L-McQueen/Syntax-error/schemes/README.md

# ⚡ Arquitectura Eléctrica y Esquemas de Conexión

<div align="center">
  <p><strong>Topología de alimentación desacoplada, gestión de buses digitales, adaptación de niveles lógicos y topología de tierras en 3nIgMa S3t3ki.</strong></p>
  <p>
    
    
    
    
  </p>
</div>

---

> [!IMPORTANT]
> Para consultar la asignación detallada de los 26 pines del conector GPIO de la Orange Pi Zero 2W, revisa directamente el documento complementario: **[PINOUT.md](PINOUT.md)**.

> [!CAUTION]
> Asegúrate de que las tierras lógicas de la Orange Pi, del ESP32-C3-Zero y de ambos convertidores LM2596 confluyan en un **nodo de tierra común en estrella**. Una tierra flotante causará pérdida de sincronismo en la trama serial UART y lecturas erróneas en el bus I2C.

---

## 🔌 1. Diagrama Jerárquico de Alimentación y Conexiones

```
                     ┌────────────────────────────────────────┐
                     │          BATERÍA LiPo 3S (11.1V)       │
                     └───────────────────┬────────────────────┘
                                         │
                         ┌───────────────┴───────────────┐
                         ▼                               ▼
               [LÍNEA DE POTENCIA]               [LÍNEA LÓGICA]
               Buck LM2596 #1 (7.8V)            Buck LM2596 #2 (5.0V)
                         │                               │
                         │               ┌───────────────┴───────────────┐
                         │               ▼                               ▼
                         │        ESP32-C3-Zero  ◄───UART (TX->RX)─── Orange Pi Zero 2W
                         │       (Control Tracción)   (115200 Baud)   (Linux ARM64 / Visión)
                         │               │                               │
                         ▼               ▼                               │
                   Driver DRV8833 ◄──────┘ (GPIO 0-3 PWM, 4 Sleep)       │
                   (Puente H MOSFET)                                     │
                         │                                               │
                         ▼                                               ▼
                  Motores N20 (100:1)                           Periféricos y Buses:
                   (Tracción 7.8V)                               - Bus I2C (/dev/i2c-2):
                                                                   * IMU MPU-6050 (0x68)
                                                                   * OLED SSD1306 (0x3C)
                                                                   * ToF Frontal VL53L1X (0x29)
                                                                   * ToF Lat. Izq VL53L0X (0x30)*
                                                                   * ToF Lat. Der VL53L0X (0x31)*
                                                                 - Bus SPI (/dev/spidev1.0):
                                                                   * PixyCam v2 (Color de suelo)
                                                                 - Puerto USB (/dev/video1):
                                                                   * Webcam USB (Marcadores ArUco)
```

---

## 🔒 2. Aislamiento Galvánico y Desacoplamiento de Ruido

Los micromotores N20 bajo carga brusca o cambios de marcha producen dos perturbaciones graves si comparten alimentación con la lógica:
1. **Caídas de Tensión (*Voltage Sags*):** Al acelerar, la demanda de corriente transitoria puede provocar caídas por debajo de los 4.65V necesarios para la Orange Pi, provocando reinicios (*brownouts*).
2. **Picos Inductivos de Retorno:** La energía inductiva almacenada en el bobinado de los motores genera picos de alta frecuencia.

### Solución Implementada:
* **Doble Regulador Buck LM2596:** Dos módulos independientes alimentados desde la misma batería LiPo 3S. El convertidor #1 abastece exclusivamente los 7.8V de potencia para el DRV8833, mientras el convertidor #2 genera 5.0V limpios con filtrado capacitivo para la SBC y el ESP32-C3-Zero (vía su pin 5V).
* **Tierra en Estrella (*Star Grounding*):** El retorno de corriente de potencia de los motores regresa directamente al borne negativo del módulo LM2596 #1 sin atravesar las pistas lógicas de la Orange Pi.

---

## ⚡ 3. Compatibilidad de Niveles Lógicos UART (3.3V Nativo)

La comunicación entre la Orange Pi Zero 2W y el ESP32-C3-Zero es **estrictamente unidireccional (Simplex)**: la Orange Pi envía paquetes de consigna de velocidad y el ESP32-C3 únicamente ejecuta sin emitir respuesta.

### Justificación de Conexión Directa a 3.3V Nativo:
Tanto el SoC Allwinner H618 de la Orange Pi Zero 2W como el microcontrolador RISC-V del ESP32-C3-Zero operan con **lógica nativa de 3.3V**:
* **Orange Pi Zero 2W:** Pin 11 (`PH2` / `UART5_TX`) emite pulsos seriales a 3.3V (115200 baudios).
* **ESP32-C3-Zero:** Pin `GPIO 20` (`RX`) recibe directamente la señal sin necesidad de divisores resistivos ni convertidores de nivel lógico (logic level shifters).
* El pin `RX` de la Orange Pi (`PH3`) permanece **desconectado**, manteniendo la topología Simplex limpia, segura y minimizando el cableado en el chasis.

---

## 🎛️ 4. Secuencia de Arranque del Bus I2C y Pines XSHUT

Los sensores de distancia VL53L0X comparten de fábrica la misma dirección I2C (`0x29`). Para operar dos sensores laterales simultáneamente en el mismo bus `/dev/i2c-2`, el sistema utiliza una secuencia de arranque secuencial controlada por software mediante los pines **XSHUT**:

```mermaid
sequenceDiagram
    participant OS as Orange Pi (Linux HAL)
    participant XSHUT as Pines GPIO XSHUT
    participant ToFL as VL53L0X Izquierdo
    participant ToFR as VL53L0X Derecho

    OS->>XSHUT: Poner XSHUT_IZQ y XSHUT_DER en LOW (Apagar ambos sensores)
    Note over ToFL,ToFR: Ambos sensores entran en Reset
    OS->>XSHUT: Poner XSHUT_IZQ en HIGH
    Note over ToFL: Enciende en dirección nativa 0x29
    OS->>ToFL: Comando I2C: Reasignar dirección a 0x30
    Note over ToFL: Ahora responde en 0x30
    OS->>XSHUT: Poner XSHUT_DER en HIGH
    Note over ToFR: Enciende en dirección nativa 0x29
    OS->>ToFR: Comando I2C: Reasignar dirección a 0x31
    Note over ToFR: Ahora responde en 0x31
    Note over OS: Bus I2C listo para lecturas continuas
```

### Pines GPIO Asignados para XSHUT:
* **XSHUT Frontal (VL53L1X):** Pin 18 (`PH4`)
* **XSHUT Lateral Izquierdo:** Pin 29 (`PI0`)
* **XSHUT Lateral Derecho:** Pin 31 (`PI15`)

---

## 🔴 5. Pulsadores de Interfaz y Parada de Emergencia

Los pulsadores físicos montados en el chasis se conectan directamente a pines GPIO con resistencia interna de pull-up activada por software:
* **Pulsador Navegar:** Pin 35 (`PI2`) -> Pulsación conecta a GND.
* **Pulsador Seleccionar:** Pin 37 (`PI16`) -> Pulsación conecta a GND.

Durante la carrera autónoma, la rutina de interrupción por cambio de estado (*edge detection*) detecta cualquier pulsación en menos de 20 ms, transmitiendo inmediatamente el paquete `M,0,0,0\n` al ESP32-C3-Zero para detener el robot en seco y regresar al menú OLED.
