L-McQueen/Syntax-error/media/README.md

# 📸 Galería Multimedia y Registros Audiovisuales (`media/`)

<div align="center">
  <p><strong>Registro fotográfico de alta resolución, vistas de ensamble y demostraciones en pista de 3nIgMa S3t3ki.</strong></p>
  <p>
    
    
    
  </p>
</div>

---

> [!TIP]
> Puedes colocar las imágenes en la subcarpeta [robot-photos/](robot-photos/) y los clips o GIFs en [videos/](videos/). Al subirlas a GitHub se visualizarán automáticamente en los marcos inferiores.

---

## 📷 1. Galería Fotográfica del Robot Físico

<div align="center">
  <table>
    <tr>
      <td align="center" width="50%">
        <strong>Vista Isométrica General</strong><br>
        Vista Isométrica<br>
        <i>Chasis completo con torres de sensores y cubierta protectora.</i>
      </td>
      <td align="center" width="50%">
        <strong>Bahía de Electrónica y Cableado</strong><br>
        Bahía de Electrónica<br>
        <i>Distribución aislada de la Orange Pi Zero 2W y el ESP32-C3-Zero.</i>
      </td>
    </tr>
    <tr>
      <td align="center" width="50%">
        <strong>Disposición Frontal de Sensores Láser ToF</strong><br>
        Sensores ToF<br>
        <i>VL53L1X centrado y sensores laterales VL53L0X a 90°.</i>
      </td>
      <td align="center" width="50%">
        <strong>Telemetría en Pantalla OLED SSD1306</strong><br>
        Pantalla OLED<br>
        <i>Menú interactivo y lecturas inerciales en vivo sin computadora.</i>
      </td>
    </tr>
  </table>
</div>

---

## 🎥 2. Demostraciones de Navegación y Pruebas en Pista

| Prueba | Descripción | Enlace / Registro |
| :--- | :--- | :---: |
| **Prueba 1: Pista A (Laberinto 5x5)** | Recorrido 100% autónomo con centrado lateral PID y retorno a casilla de meta sin colisiones. |  |
| **Prueba 2: Pista B (Detección de Rampas)** | Fusión inercial del filtro complementario adaptando la tracción al detectar subida y bajada. |  |
| **Prueba 3: Diagnóstico en Pits** | Verificación de los buses I2C y UART utilizando los pulsadores físicos y la pantalla OLED. |  |
