L-McQueen/Syntax-error/robot-logic/README.md

# 🧠 Lógica de Control, Matemáticas y Algoritmos

<div align="center">
  <p><strong>Fusión sensorial inercial, control lateral PID, máquinas de estados (FSM) y cinemática para 3nIgMa S3t3ki.</strong></p>
  <p>
    
    
    
    
  </p>
</div>

---

> [!NOTE]
> Cada modelo cinemático y ecuación diferencial de control fue verificado primero en el gemelo digital en Webots bajo condiciones de ruido estocástico antes de compilarse en la Capa de Abstracción de Hardware (HAL) de la Orange Pi.

---

## 🧭 1. Fusión Sensorial y Filtro Complementario (Eje Y)

El sensor inercial **MPU-6050** está orientado físicamente con su **eje Y coincidente con la dirección de avance longitudinal** del chasis.

```
                     ORIENTACIÓN DEL SENSOR MPU-6050 EN EL CHASIS
                                        [FRENTE]
                                           ▲
                                           │  +Y (Avance / Cabeceo Pitch)
                                           │
                           -X ◄────────────┼────────────► +X (Aceleración Lateral)
                                           │
                                           ⊙ +Z (Vertical Up / Guiñada Yaw)
                                        [TRASERA]
```

### A. Guiñada Horizontal (Yaw en Eje Z)
Para el seguimiento de rumbo en giros de 90° exactos dentro del laberinto:

1. **Calibración de Sesgo (*Bias*):**  
   Al encender el robot, durante los primeros 2.0 segundos de reposo se promedian 100 muestras de velocidad angular en $Z$ para obtener el error estático $b_z$.

2. **Filtro de Zona Muerta (*Deadband*):**  
   Para evitar que el ruido térmico acumule deriva durante tramos rectos, la velocidad angular se filtra según:

$$
\omega_{z,\text{filtrado}} = 
\begin{cases} 
0 & \text{si } |\omega_z - b_z| < 0.25^\circ/\text{s} \\ 
\omega_z - b_z & \text{en otro caso} 
\end{cases}
$$

3. **Integración Trapezoidal:**  
   A una frecuencia estricta de $f = 50\text{ Hz}$ ($\Delta t = 0.02\text{ s}$), el ángulo de rumbo acumulado se calcula mediante:

$$
\theta_{\text{yaw}}(k) = \theta_{\text{yaw}}(k-1) + \omega_{z,\text{filtrado}} \cdot \Delta t
$$

---

### B. Cabeceo Longitudinal (Pitch en Eje Y) y Detección de Rampas
Para detectar rampas ascendentes y contar correctamente las casillas:

1. **Estimación por Acelerómetro:**  
   El ángulo de inclinación a partir de las componentes de la aceleracion se obtiene con:

$$
\theta_{\text{acc}} = \text{atan2}\left(A_y, \sqrt{A_x^2 + A_z^2}\right) \cdot \left(\frac{180}{\pi}\right)
$$

2. **Filtro Complementario:**  
   Combina la respuesta instantánea del giróscopo en $X$ con la estabilidad a largo plazo del acelerómetro:

$$
\theta_{\text{pitch}}(k) = 0.96 \cdot (\theta_{\text{pitch}}(k-1) + \omega_x \cdot \Delta t) + 0.04 \cdot \theta_{\text{acc}}
$$

3. **Clasificador Dinámico de Terreno:**
   * $\theta_{\text{pitch}} > +6.0^\circ \implies$ **SUBIDA** (robot ascendiendo rampa).
   * $\theta_{\text{pitch}} < -6.0^\circ \implies$ **BAJADA** (robot descendiendo rampa).
   * $-6.0^\circ \le \theta_{\text{pitch}} \le +6.0^\circ \implies$ **PLANO** (superficie horizontal).

---

## 🎯 2. Control Lateral de Centrado PID en Pasillos de 30 cm

En la Pista A (Laberinto), el robot debe navegar a través de celdas de $30\text{ cm} \times 30\text{ cm}$ sin rozar las paredes laterales ni oscilar en pasillos abiertos.

```
                  [Pared Izquierda]                       [Pared Derecha]
             │ ◄─────── 10-15 cm ──────► [Robot] ◄────── 10-15 cm ──────► │
             │   Zona de Peligro: < 10cm          Zona de Peligro: < 10cm │
             │   (Empuje hacia la der)            (Empuje hacia la izq)   │
             │   Zona Neutra: 10 - 15 cm          Zona Neutra: 10 - 15 cm │
             │   (Avance Recto Estable)           (Avance Recto Estable)  │
```

---

### A. Ecuación Geométrica del Error Lateral por Zonas

Para asegurar estabilidad absoluta tanto si existen dos paredes como si el robot pasa junto a una sola pared en una bifurcación:

#### Caso 1: Con 2 Paredes Laterales ($d_L < 22\text{ cm}$ y $d_R < 22\text{ cm}$)
Centrado equidistante simétrico respecto al centro del pasillo:

$$
e(t) = \frac{d_L(t) - d_R(t)}{2}
$$

#### Caso 2: Con 1 Sola Pared (Referencia Pared Izquierda)
Aplica una zona muerta de tolerancia entre 10 cm y 15 cm:

$$
e(t) = 
\begin{cases}
d_L - 0.10 & \text{si } d_L < 0.10\text{ m} \quad (\text{empuje a la derecha para no rozar}) \\
d_L - 0.15 & \text{si } d_L > 0.15\text{ m} \quad (\text{atracción suave hacia la pared}) \\
0.0 & \text{si } 0.10\text{ m} \le d_L \le 0.15\text{ m} \quad (\text{zona neutra: avance recto})
\end{cases}
$$

#### Caso 3: Con 1 Sola Pared (Referencia Pared Derecha)

$$
e(t) = 
\begin{cases}
0.10 - d_R & \text{si } d_R < 0.10\text{ m} \quad (\text{empuje a la izquierda para no rozar}) \\
0.15 - d_R & \text{si } d_R > 0.15\text{ m} \quad (\text{atracción suave hacia la pared}) \\
0.0 & \text{si } 0.10\text{ m} \le d_R \le 0.15\text{ m} \quad (\text{zona neutra: avance recto})
\end{cases}
$$

#### Caso 4: En Espacio Abierto o Intersección ($d \ge 22\text{ cm}$)
El PID se desconecta de inmediato ($e = 0.0$) para evitar correcciones falsas al pasar junto a puertas o cruces.

---

### B. Salida de Control y Modulación de Motores

El error calculado alimenta la ley de control proporcional-derivativa:

$$
u(t) = K_p \cdot e(t) + K_d \cdot \frac{e(t) - e(t - \Delta t)}{\Delta t}
$$

* **Comando Diferencial de Velocidad:**

$$
\begin{aligned}
PWM_{\text{izq}} &= PWM_{\text{base}} - u(t) \\
PWM_{\text{der}} &= PWM_{\text{base}} + u(t)
\end{aligned}
$$

* **Parámetros Sintonizados:**
  - $PWM_{\text{base}} = 160$ (equivalente a $4.2\text{ rad/s}$ en ruedas a 7.8V).
  - $K_p = 1.45$: Corrección proporcional rápida ante desvíos.
  - $K_d = 0.35$: Amortiguamiento para evitar oscilaciones pendulares entre paredes.

---

### C. Estimador Físico de Ángulo con Muros ($\theta_{\text{walls}}$) y Autocalibración del IMU

El giróscopo MPU-6050 económico presenta una deriva térmica continua ($\pm 0.15^\circ/\text{s}$). Tras 60 segundos de carrera, acumula entre $15^\circ$ y $25^\circ$ de desvío; al girar a $90^\circ$, el robot en realidad gira $70^\circ$, entrando cruzado a los pasillos y colisionando.

#### Principio Físico:
En un laberinto ortogonal, **las paredes del pasillo siempre apuntan a los rumbos cardinales físicos exactos ($0^\circ, 90^\circ, 180^\circ, 270^\circ$)**.

```
                EJE LONGITUDINAL DEL PASILLO (PAREDES)
        ─────────────────────────────────────────────────────────────►
                       \
                        \  θ_walls (Ángulo físico relativo al muro)
                         \
                          ► [ROBOT] (Avanza a velocidad lineal v)
```

#### Procedimiento de Estimación y Compensación Continua:

1. **Evolución Temporal de la Métrica Lateral $m$:**  
   Al avanzar en el pasillo a velocidad constante $v = 0.084\text{ m/s}$, el robot registra la evolución temporal de la métrica lateral $m$:

$$
m(t) = 
\begin{cases}
\dfrac{d_L(t) - d_R(t)}{2} & \text{si hay 2 paredes} \\
d_L(t) & \text{si hay pared izquierda} \\
-d_R(t) & \text{si hay pared derecha}
\end{cases}
$$

2. **Estimación del Ángulo Físico Real con los Muros ($\theta_{\text{walls}}$):**  
   Sobre una ventana temporal $\Delta t$ con desplazamiento $\Delta s = v \cdot \Delta t$:

$$
\theta_{\text{walls}} = -\frac{1}{v} \frac{dm}{dt} = -\frac{m(t) - m(t - \Delta t)}{\Delta s}
$$

donde $\theta_{\text{walls}}$ representa el ángulo físico real del chasis respecto a las paredes, acotado por seguridad a $\pm 15^\circ$.

3. **Cálculo de la Deriva Instantánea del IMU ($\epsilon_{\text{deriva}}$):**  
   La diferencia entre el rumbo que reporta el giróscopo ($\psi_{\text{imu}}$) y la orientación física del muro ($\psi_{\text{meta}} + \theta_{\text{walls}}$) es la **deriva neta del IMU**:

$$
\epsilon_{\text{deriva}} = \mathrm{wrap}\left(\psi_{\text{imu}} - \psi_{\text{meta}} - \theta_{\text{walls}}\right)
$$

4. **Compensación Dinámica en Vivo ($\psi_{\text{offset}}$):**  
   En cada ciclo de control a 50 Hz, el software absorbe suavemente esta deriva en su sesgo acumulado:

$$
\psi_{\text{offset}} \leftarrow \psi_{\text{offset}} + 0.035 \cdot \epsilon_{\text{deriva}}
$$

**Resultado en Pista:** Conforme el robot recorre cualquier pasillo recto, su rumbo interno se calibra en tiempo real contra los muros. Al llegar a la siguiente intersección, la deriva acumulada es inferior a $\pm 1.5^\circ$, garantizando giros ortogonales perfectos a $90.0^\circ$ y centrado automático sin necesidad de encoders de rueda ni brújulas magnetométricas.

---

## 📏 3. Odometría sin Encoders: Dead-Reckoning a 7.8V

Debido a que el chasis opera sin encoders de rueda físicos, se implementó un modelo de odometría redundante basado en la curva lineal del motor N20 alimentado a tensión fija estabilizada:

1. **Relación Tensión-Velocidad:**

$$
\text{RPM}_{7.8\text{V}} = 260.0 \times \left(\frac{7.8\text{ V}}{6.0\text{ V}}\right) = 338.0\text{ RPM}
$$

$$
\omega_{\text{max}} = 338.0 \times \frac{2\pi}{60} = 35.39\text{ rad/s}
$$

2. **Velocidad Lineal de Crucero ($R = 0.02\text{ m}$):**  
   Comandando a $\omega_{\text{crucero}} = 4.2\text{ rad/s}$:

$$
v_{\text{lin}} = \omega_{\text{crucero}} \times R = 4.2 \times 0.02 = 0.084\text{ m/s} \quad (8.4\text{ cm/s})
$$

3. **Corrección Óptica por ToF Frontal:**  
   El avance por casilla de 30 cm se programa por temporización ($T_{\text{celda}} = 0.30 / 0.084 = 3.57\text{ s}$), pero cada vez que el sensor frontal VL53L1X detecta una pared transversal a menos de 40 cm, **reemplaza la estimación temporal por la distancia milimétrica absoluta**, reseteando cualquier error acumulado de patinaje de rueda.

---

## 🔄 4. Máquinas de Estados Finitas (FSM)

### FSM Pista A: Laberinto MAZE (5x5)
El robot implementa un explorador DFS (*Depth-First Search*) guiado por sensores de pared:

```mermaid
stateDiagram-v2
    [*] --> INICIALIZACION
    INICIALIZACION --> ESPERA_PULSADOR: Calibrar IMU y Sensores
    ESPERA_PULSADOR --> AVANZAR_CENTRADOPID: Botón Seleccionar
    
    AVANZAR_CENTRADOPID --> EVALUAR_CELDA: Avanzó casilla (30 cm)
    EVALUAR_CELDA --> DETECCION_COLOR: Clasificar baldosa
    
    DETECCION_COLOR --> META_ALCANZADA: Color Rojo (Meta)
    DETECCION_COLOR --> DECISION_GIRO: Color Blanco o Bonus
    
    DECISION_GIRO --> GIRO_90_GRADOS: Giro a la derecha libre
    DECISION_GIRO --> AVANZAR_CENTRADOPID: Camino recto libre
    DECISION_GIRO --> CALLEJON_RETORNO: Giro 180° si es callejón
    
    GIRO_90_GRADOS --> AVANZAR_CENTRADOPID
    CALLEJON_RETORNO --> AVANZAR_CENTRADOPID
    
    META_ALCANZADA --> DETENIDO: Parada y Telemetría Final
    DETENIDO --> [*]
```

### FSM Pista B: Desniveles y Rampas
Supervisa activamente el ángulo de cabeceo (*Pitch*) para adaptar la tracción:
* **Estado NORMAL:** Tracción estándar en tramo plano.
* **Estado EN_RAMPA_SUBIDA ($\theta_{\text{pitch}} > +6^\circ$):** Incrementa PWM a 210 para superar la pendiente sin atascos.
* **Estado EN_RAMPA_BAJADA ($\theta_{\text{pitch}} < -6^\circ$):** Reduce PWM a 120 aplicando contramarcha leve para descenso controlado.
* **Estado APERTURA_COMPUERTA:** Al llegar a la zona de descarga, envía orden serial para que el servo SG90 abra la compuerta durante 2.5 segundos.

---

## 🛡️ 5. Mecanismo Watchdog de Seguridad (Hardware Failsafe a 300 ms)

Para evitar que el robot colisione si el proceso Python en Linux se congela o sufre sobrecarga de memoria:

```mermaid
sequenceDiagram
    participant Pi as Orange Pi (Linux)
    participant Esp as ESP32-C3-Zero (C++)
    participant M as Motores N20

    loop Cada 50 ms (20 Hz)
        Pi->>Esp: Trama serial 'M,vel_izq,vel_der,servo\n'
        Note over Esp: Resetea temporizador Watchdog a 0 ms
        Esp->>M: Genera PWM correspondiente
    end

    Note over Pi: Falla o cuelgue del software en Linux
    Note over Esp: El temporizador supera 300 ms sin recibir trama
    Esp->>M: CORTAR ENERGÍA INMEDIATAMENTE (PWM = 0)
    Note over Esp: Estado FAILSAFE de parada de emergencia
```
