L-McQueen/Syntax-error/src/README.md

# 💻 Arquitectura de Software y Código Fuente (`src/`)

<div align="center">
  <p><strong>Diseño de software desacoplado: Computación de alto nivel en Linux ARM64, control de tiempo real en C++ (ESP32-C3) y gemelo digital Sim2Real en Webots.</strong></p>
  <p>
    
    
    
    
  </p>
</div>

---

> [!NOTE]
> La suite de código está organizada en tres subsistemas completamente independientes para permitir pruebas modulares aisladas antes de la integración total en campo.

---

## 📂 Organización de Carpetas en `src/`

```
📦 src
├── 📁 esp32/                         # Control de tracción y PWM determinista a 20 kHz (C++)
│   └── 📁 firmware_motor_controller/
│       └── 📄 firmware_motor_controller.ino # Sketch ESP32-C3 con Watchdog de 300 ms y PWM LEDC
│
├── 📁 orange/                        # Software de alto nivel en Linux (Python)
│   ├── 📄 main.py                    # Orquestador autónomo de competencia y FSM
│   ├── 📄 menu.py                    # Interfaz gráfica OLED (SSD1306) y botones GPIO
│   ├── 📄 robot_hal.py               # Capa de Abstracción de Hardware (HAL) multihilo
│   ├── 📄 sync.bat / sync.ps1        # Scripts de sincronización rápida con purga automática
│   └── 📁 tests/                     # Suite de pruebas unitarias de hardware
│       ├── 📄 test_screen.py         # Test de renderizado en pantalla OLED
│       ├── 📄 test_imu.py            # Test y calibración de 6 ejes MPU-6050
│       ├── 📄 test_tof.py            # Test 3x sensores ToF con filtro en cascada (VL53L1X + VL53L0X)
│       └── 📄 test_imu_screen.py     # Integración conjunta IMU + OLED + ToF en tiempo real
│
└── 📁 webots-sim2real/               # Gemelo digital de competencia en Webots
    ├── 📁 controllers/               # Controladores Python de simulación y supervisores
    ├── 📁 worlds/                    # Mundos virtuales 3D de Pista A (Maze) y Pista B (Niveles)
    ├── 📁 scripts/                   # Scripts auxiliares de generación procedural
    ├── 📁 docs/                      # Documentación del gemelo digital
    ├── 📄 launch.bat                 # Lanzador en un clic para Webots
    └── 📄 README.md                  # Documentación profunda de la simulación
```

---

## 🔄 Flujo de Datos e Interacción entre Módulos

```
 ┌────────────────────────────────────────────────────────────────────────┐
 │                         GEMELO DIGITAL (Webots)                        │
 │  * Simulación con ruido estocástico de sensores ToF y deriva inercial  │
 │  * Validación de la FSM de Pista A y Pista B antes de tocar hardware   │
 └───────────────────────────────────┬────────────────────────────────────┘
                                     │ Transferencia de Código Sim2Real
                                     ▼
 ┌────────────────────────────────────────────────────────────────────────┐
 │                      ORANGE PI ZERO 2W (src/orange/)                   │
 │                                                                        │
 │   [menu.py] (OLED + Botones) ──► [main.py] (FSM Competencia)           │
 │                                        │                               │
 │                                        ▼                               │
 │                             [robot_hal.py] (HAL Multihilo)             │
 │                             - Hilo I2C: MPU-6050 + ToFs Láser          │
 │                             - Hilo UART: Transmisor hacia ESP32-C3     │
 └───────────────────────────────────┬────────────────────────────────────┘
                                     │ Trama Serial UART (115200 Baud)
                                     │ "M,vel_izq,vel_der,servo\n"
                                     ▼
 ┌────────────────────────────────────────────────────────────────────────┐
 │                  ESP32-C3-ZERO (src/esp32/)                            │
 │                                                                        │
 │   [firmware_motor_controller.ino]                                      │
 │   - Decodificación en tiempo real de consignas de velocidad            │
 │   - Generación determinista de PWM (20 kHz) hacia driver DRV8833       │
 │   - Temporizador Watchdog: Si no hay trama en 300 ms -> Corte a cero  │
 └────────────────────────────────────────────────────────────────────────┘
```

---

## 🚀 Guía de Ejecución y Despliegue

### 1. Flashear el Firmware en el ESP32-C3-Zero
1. Abre el Arduino IDE.
2. Carga el archivo `src/esp32/firmware_motor_controller/firmware_motor_controller.ino`.
3. Selecciona la placa **ESP32C3 Dev Module** (ESP32 by Espressif) con `USB CDC On Boot: Enabled` y el puerto COM asignado.
4. Conecta el ESP32-C3-Zero por USB-C (si es necesario mantén presionado **BOOT**, pulsa **RESET** y suelta **BOOT**) y presiona **Subir** (*Upload*).

### 2. Sincronizar el Software con la Orange Pi
Desde tu computadora de desarrollo en Windows:
```cmd
cd src/orange
./sync.bat
```
*(El script purga automáticamente los scripts viejos en la Orange Pi para garantizar sincronización en limpio).*

### 3. Ejecutar Pruebas Modulares de Hardware
Conéctate por SSH a la Orange Pi y corre las pruebas individuales:
```bash
# Prueba de pantalla OLED
python3 ~/orange/tests/test_screen.py

# Prueba del sensor inercial
python3 ~/orange/tests/test_imu.py

# Prueba de sensores ToF (Frontal VL53L1X + Laterales VL53L0X con filtro cascada)
python3 ~/orange/tests/test_tof.py

# Prueba combinada IMU + pantalla + ToF
python3 ~/orange/tests/test_imu_screen.py
```

### 4. Lanzar la Simulación en Webots
En tu equipo con Webots instalado:
```cmd
cd src/webots-sim2real
launch.bat
```
