L-McQueen/Syntax-error/pinout.jpeg

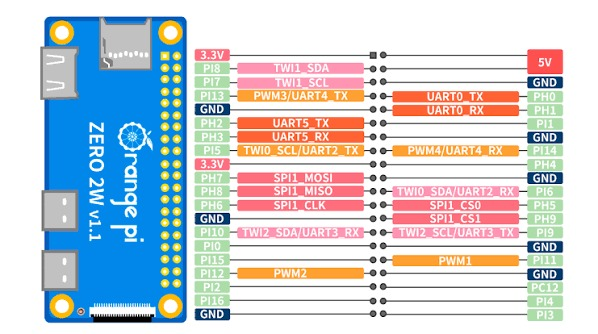
pinout.jpeg
