L-McQueen/Syntax-error/src/webots-sim2real/worlds/textures/aruco.bmp

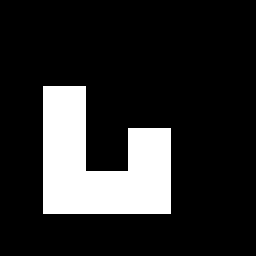
src/webots-sim2real/worlds/textures/aruco.bmp
