L-McQueen/Syntax-error/components/README.md

# ⚙️ Guía Maestra de Componentes de Hardware

<div align="center">
  <p><strong>Análisis exhaustivo, hojas de datos, consumo eléctrico y justificación técnica de cada subsistema en 3nIgMa S3t3ki.</strong></p>
  <p>
    
    
    
    
  </p>
</div>

---

> [!NOTE]
> Cada componente fue seleccionado rigurosamente bajo criterios de: inmunidad al ruido electromagnético, bajo consumo, determinismo en tiempo real y cumplimiento de las restricciones dimensionales y presupuestarias de **Candidates 2026**.

---

## 📑 Tabla Sinóptica de Especificaciones

| Componente | Rol en el Robot | Protocolo / Bus | Voltaje Lógico | Alimentación | Justificación Técnica Clave |
| :--- | :--- | :--- | :--- | :--- | :--- |
| **Orange Pi Zero 2W** | Computadora de Abordo (SBC) | Linux OS / Debian 12 | 3.3V | 5.0V / 2.0A | Procesamiento multinúcleo para visión, FSM y HAL multihilo |
| **ESP32-C3-Zero** | Controlador de Tracción (MCU) | UART (`/dev/ttyS5`) | 3.3V | 5.0V / 3.3V | Generación determinista de PWM LEDC a 20 kHz sin latencia de SO |
| **DRV8833** | Driver Puente H Dual MOSFET | PWM (GPIO 0, 1, 2, 3) | 3.3V - 5.0V | 7.8V Estabilizado | Caída de voltaje casi nula ($\approx 0.1\text{V}$) frente al L298N |
| **Micromotores N20 (100:1)**| Actuadores de Tracción | Salidas Puente H | N/A | 7.8V (Potencia) | Alto torque con caja reductora metálica para subir rampas |
| **Pololu VL53L1X** | Sensor Frontal de Distancia | I2C (`/dev/i2c-2`, 0x29) | 3.3V | 3.3V / 5.0V | Rango láser largo de hasta 4.0 m con cono milimétrico estrecho |
| **Pololu VL53L0X (x2)** | Sensores Laterales ToF | I2C (0x30 y 0x31) | 3.3V | 3.3V / 5.0V | Medición precisa en pasillos de 30 cm sin eco acústico falso |
| **GY-521 (MPU-6050)** | Sensor Inercial (IMU 6-DOF) | I2C (`/dev/i2c-2`, 0x68) | 3.3V | 3.3V / 5.0V | Fusión trapezoidal en Yaw (Z) y filtro complementario de Pitch (Y) |
| **SSD1306 OLED 0.96"** | Interfaz Visual y Telemetría | I2C (`/dev/i2c-2`, 0x3C) | 3.3V | 3.3V / 5.0V | Diagnóstico en pista sin depender de WiFi ni monitores externos |
| **LM2596 Step-Down (x2)** | Regulación de Tensión DC-DC | Salidas fijas | N/A | Entrada 11.1V LiPo | Aislamiento galvánico: riel de motores (7.8V) vs riel lógico (5.0V) |
| **Cámaras (Webcam / Pixy)**| Visión Artificial Híbrida | USB (V4L2) / SPI | 5.0V / 3.3V | 5.0V | Detección ArUco por OpenCV y clasificación instantánea de color |

---

## 🔍 1. Orange Pi Zero 2W (Cerebro Principal)

* **Procesador (SoC):** Allwinner H618 Quad-Core ARM Cortex-A53 a 1.5 GHz.
* **Memoria:** 1 GB / 1.5 GB LPDDR4.
* **Conectividad:** Wi-Fi 5 (802.11ac) + Bluetooth 5.0 (usado únicamente para sincronización de código en pits, apagado en competencia).
* **Buses Integrados Usados:**
  - `/dev/i2c-2`: Conectado a IMU, pantalla OLED y los 3 sensores ToF.
  - `/dev/spidev1.0`: Bus SPI de alta velocidad para visión complementaria.
  - `/dev/ttyS5`: Puerto serial UART a 115200 baudios hacia el ESP32-C3-Zero.
* **Por qué se eligió:** Ofrece un costo 3 veces menor que una Raspberry Pi 4 con capacidad completa para ejecutar OpenCV, hilos concurrentes de sensado y algoritmos de grafo para laberintos.

---

## ⚡ 2. Waveshare ESP32-C3-Zero (Controlador de Potencia y Tiempo Real)

* **Microcontrolador:** Espressif ESP32-C3 (Procesador RISC-V 32-bit de un solo núcleo a 160 MHz).
* **Factor de Forma Miniatura:** $23.5 \times 18.0\text{ mm}$ con pad almenado, liberando más del 85% del volumen en el piso inferior del chasis respecto al Arduino Uno.
* **Nivel Lógico Nativo a 3.3V:** Voltaje lógico 100% compatible con los 3.3V de la Orange Pi Zero 2W, eliminando disparidades o riesgos eléctricos.
* **Generación de PWM por Hardware (LEDC a 20 kHz):** Generación de PWM de alta frecuencia inaudible que suprime por completo el zumbido acústico de los micromotores N20, sin colisiones de temporizador con el micro-servo SG90.
* **Función y Seguridad:** Ejecución determinista del tren de pulsos y Watchdog de seguridad (failsafe de parada a los 300 ms sin comandos).
* **Comunicación Simplex:** Recibe comandos en formato `M,vel_izq,vel_der,servo\n` a 115200 baudios por su pin RX (GPIO 20).

---

## 🚗 3. Driver DRV8833 vs. Puente H L298N

* **Tecnología:** Puentes H basados en MOSFETs integrados con protección térmica y por sobrecorriente.
* **Resistencia de Conducción:** $R_{DS(on)} \approx 0.2\ \Omega$.
* **Comparativa Crítica con L298N:**
  - El clásico L298N utiliza transistores bipolares BJT que tienen una caída interna de hasta $2.0\text{ V}$. En una batería de 7.8V, un L298N desperdicia casi el 25% de la energía disipando calor masivo.
  - El DRV8833 tiene una caída inferior a $0.1\text{ V}$, permitiendo transferir prácticamente el 100% del voltaje a los motores con tamaño minúsculo ($18 \times 15\text{ mm}$).

---

## 📏 4. Sensores de Distancia Láser ToF vs. Ultrasonidos HC-SR04

* **Sensor Frontal:** Pololu VL53L1X (Emisor láser VCSEL de 940 nm clase 1, alcance $4.0\text{ m}$).
* **Sensores Laterales:** Pololu VL53L0X (Alcance hasta $2.0\text{ m}$, optimizado para $5 - 30\text{ cm}$).
* **¿Por qué NO ultrasónicos HC-SR04?:**
  - El HC-SR04 emite un cono acústico de $15^\circ - 30^\circ$. En un laberinto con casillas de 30 cm, las ondas sonoras rebotan oblicuamente contra las paredes contiguas (*efecto multi-trayectoria*), generando lecturas fantasma.
  - El láser ToF mide la velocidad de la luz en un haz colimado de milímetros, garantizando mediciones ortogonales exactas independientemente del color o textura de la pared.

---

## 🧭 5. Sensor Inercial GY-521 (MPU-6050)

* **Ejes:** Giróscopo de 3 ejes ($\pm 250^\circ/\text{s}$ a $\pm 2000^\circ/\text{s}$) + Acelerómetro de 3 ejes ($\pm 2g$ a $\pm 16g$).
* **Frecuencia de Muestreo:** Bucle de lectura dedicado a 50 Hz.
* **Alineación Física en Chasis:**
  - Eje Y montado rígidamente en la dirección de avance longitudinal.
  - Eje Z vertical para integración de Yaw (guiñada) en giros.
* **Compensación de Sesgo (*Bias*):** Rutina de calibración en reposo durante los primeros 2 segundos de arranque con filtro de zona muerta a $0.25^\circ/\text{s}$.

---

## 📺 6. Pantalla OLED SSD1306 (0.96", 128x64 píxeles)

* **Interfaz:** I2C con dirección esclava `0x3C`.
* **Consumo:** $\approx 20\text{ mA}$ promedio (tecnología autoemisiva, no requiere luz de fondo).
* **Utilidad en Competencia:**
  - Selección de pista sin computadora (Pista A: Laberinto / Pista B: Desniveles).
  - Telemetría en vivo: ángulo Yaw, estado de rampa (SUBIDA / BAJADA / PLANO) y voltaje de batería.
  - Parada de emergencia y menú de diagnóstico de sensores en pits.

---

## 🔋 7. Distribución de Potencia: Batería LiPo 3S y Reguladores LM2596

* **Fuente Primaria:** Batería de Polímero de Litio (LiPo) 3S (11.1V nominal, 12.6V a plena carga).
* **Regulador LM2596 #1 (Potencia Motores):** Calibrado a $7.8\text{ V}$ continuos con condensador de filtro de bajo ESR. Alimenta exclusivamente el DRV8833.
* **Regulador LM2596 #2 (Lógica Limpia):** Calibrado a $5.0\text{ V}$ para la Orange Pi Zero 2W y el ESP32-C3-Zero (pin 5V).
* **Aislamiento Galvánico:** Esta separación física impide que los picos inductivos de los motores generen caídas momentáneas de voltaje (*voltage sags*), previniendo reinicios repentinos (*brownouts*) en el procesador.

---

## 📷 8. Cámara de Visión Artificial Inteligente: Pixy2 (PixyCam v2)

* **Documentación Completa:** Consulta la ficha técnica detallada, cableado SPI y protocolo binario en [components/pixy2.md](pixy2.md).
* **Procesador de Visión Propio:** Doble núcleo NXP LPC4330 a 204 MHz; procesa la imagen a 60 FPS sin cargar la CPU de la Orange Pi.
* **Interfaz Principal en Robot:** Bus SPI `/dev/spidev1.0` a 2 MHz (Pines 19, 21, 23, 24).
* **Funciones Clave:** Detección instantánea de colores (puertas y balizas), seguimiento de líneas de pista y lectura de códigos de barras en el suelo.
* **Lámpara Integrada:** LED blanco de alta potencia para iluminar pasillos oscuros del laberinto bajo comando por software.
