L-McQueen/Syntax-error/(commit log)

2026-10-13 fix(docs): formatear bloques LaTeX para renderizado nativo en GitHub
2026-10-13 Clarify ramp detection explanation in README
    Updated the explanation for detecting ramps in section B to clarify the use of accelerometer components.
2026-10-13 docs: integrar deduccion fisica completa de centrado lateral y estimador theta_walls
2026-10-13 correccion de rutas
2026-10-16 pruebas, sensores, etc
2026-10-16 no cabe el uno xdddddd :v y como necesitaba compar un nuevo driver, cambiamos el uno por un micro que es del tamaño de una moneda lol
2026-10-16 feat: add motor firmware, test scripts, component docs, and pinout schemes
2026-10-16 feat: add motor controller firmware and initial robot hardware abstraction layer
